kyo0221/aif_rc_teleop_ecu/production/parts_list.xlsx

Sheet: JLC実装部品
製作枚数 | 5 | ← 黄色セルを変えると数量・小計が再計算されます（Economic PCBA で実装する表面実装部品。単価・在庫はJLC API 2026-11-09取得）
No | Ref | 値 | パッケージ | LCSC番号 | メーカー型番 | 区分 | 1枚あたり数量 | 必要数 | 単価(USD) | 小計(USD) | 状態 | 備考
1 | C2,C6,C9,C10,C11,C12,C14,C20,C23 | 100nF 50V X7R ±10% | 0603 | C14663 | CC0603KRX7R9BB104 | Basic | 9 |  | 0.0060 |  | 確認済 2026-11-09 | バイパス/デカップリング JLC在庫 32,993,629（2026-11-09）
2 | C4,C5,C8,C15,C21,C24 | 1µF 50V X5R ±10% | 0603 | C15849 | CL10A105KB8NNNC | Basic | 6 |  | 0.0109 |  | 確認済 2026-11-09 | JLC在庫 12,623,126（2026-11-09）
3 | C7 | 10nF 50V X7R ±10% | 0603 | C57112 | 0603B103K500NT | Basic | 1 |  | 0.0103 |  | 確認済 2026-11-09 | JLC在庫 5,750,512（2026-11-09）
4 | C13 | 4.7µF 16V X5R ±10% | 0603 | C19666 | CL10A475KO8NNNC | Basic | 1 |  | 0.0150 |  | 確認済 2026-11-09 | C13 JLC在庫 3,723,176（2026-11-09）
5 | C16,C17 | 33pF 50V C0G ±5% | 0603 | C1663 | CL10C330JB8NNNC | Basic | 2 |  | 0.0091 |  | 確認済 2026-11-09 | Y1(CL=20pF)用。33pF直列16.5pF+浮遊容量で適合 JLC在庫 1,421,873（2026-11-09）
6 | C19,C22 | 10µF 25V X5R ±10% | 0805 | C15850 | CL21A106KAYNNNE | Basic | 2 |  | 0.0315 |  | 確認済 2026-11-09 | C19/C22 JLC在庫 8,362,759（2026-11-09）
7 | D1 | LED 黄緑 Vf2.0-2.2V 30-42mcd | 0603 | C2289 | KT-0603YG | Extended | 1 |  | 0.0106 |  | 確認済 2026-11-09 | D1=状態。色決定済み(黄緑)。暗さは実機確認 JLC在庫 36,894（2026-11-09）
8 | D2,D3,D4 | LED 赤 Vf1.8-2.4V | 0603 | C2286 | KT-0603R | Basic | 3 |  | 0.0077 |  | 確認済 2026-11-09 | D2=異常 D3=5V表示 D4=3.3V表示。色決定済み(赤)。暗さは実機確認 JLC在庫 6,497,473（2026-11-09）
9 | D5 | LED 黄 Vf2.4V 175mcd | 0603 | C2287 | KT-0603Y | Extended | 1 |  | 0.0106 |  | 確認済 2026-11-09 | D5=モード。色決定済み(黄)。暗さは実機確認 JLC在庫 86,988（2026-11-09）
10 | FB1 | 330Ω@100MHz 700mA | 0402 | C596498 | BLM15EX331SN1D | Extended | 1 |  | 0.0899 |  | 確認済 2026-11-09 | FB1 JLC在庫 36,595（2026-11-09）
11 | R1 | 120Ω ±1% | 0603 | C22787 | 0603WAF1200T5E | Basic | 1 |  | 0.0020 |  | 確認済 2026-11-09 | CAN終端 JLC在庫 2,693,768（2026-11-09）
12 | R2 | 3.3kΩ ±1% | 0603 | C22978 | 0603WAF3301T5E | Basic | 1 |  | 0.0022 |  | 確認済 2026-11-09 | 5V表示LED(D3) JLC在庫 4,761,882（2026-11-09）
13 | R3,R4,R5,R6 | 1.2kΩ ±1% | 0603 | C22765 | 0603WAF1201T5E | Basic | 4 |  | 0.0034 |  | 確認済 2026-11-09 | LED電流制限(D1,D2,D4,D5) JLC在庫 2,156,026（2026-11-09）
14 | R7 | 10kΩ ±1% | 0603 | C25804 | 0603WAF1002T5E | Basic | 1 |  | 0.0022 |  | 確認済 2026-11-09 | BOOT0プルダウン JLC在庫 46,759,857（2026-11-09）
15 | SW1 | タクトスイッチ SMD-4P 5.1×5.1 | SMD 5.1x5.1 | C318884 | TS-1187A-B-A-B | Basic | 1 |  | 0.0207 |  | 確認済 2026-11-09 | リセットSW。接点ペア要確認(要確認シート) JLC在庫 844,638（2026-11-09）
16 | U1 | STM32G474RET6 | LQFP-64 | C521608 | STM32G474RET6 | Extended | 1 |  | 13.0055 |  | 確認済 2026-11-09 | JLC在庫 153個（2026-11-09時点）。少量のため発注直前に再確認
17 | U2 | XC6206P332MR 3.3V LDO | SOT-23-3 | C5446 | XC6206P332MR-G | Basic | 1 |  | 0.1478 |  | 確認済 2026-11-09 | 入力最大6V JLC在庫 490,069（2026-11-09）
18 | U3 | CA-IS3062VW 絶縁CAN(電源内蔵) | SOIC-16W | C5338808 | CA-IS3062VW | Extended | 1 |  | 3.0163 |  | 確認済 2026-11-09 | JLC在庫 3,809個（2026-11-09時点）
19 | Y1 | 8MHz 20pF ±10ppm | 5032 2P | C115962 | X50328MSB2GI | Basic | 1 |  | 0.2461 |  | 確認済 2026-11-09 | X50328MSB2GI JLC在庫 498,737（2026-11-09）
 |  |  |  |  |  |  |  |  | 部品代合計
 |  |  |  |  |  |  |  |  | 拡張部品の品種数
 |  |  |  |  |  |  |  |  | 拡張部品手数料(目安$3/品種)

Sheet: 手はんだ部品_購入リスト
製作枚数 |  | JLCPCBの注文時にLCSCで同梱購入する想定（購入数は最小購入数を考慮。単価はJLC API 2026-11-09取得）
No | 品目 | Ref | LCSC番号 | メーカー型番 | 仕様 | 1枚あたり数量 | 必要数 | 最小購入数 | 購入数 | 単価(USD) | 小計(USD) | 購入先 | 備考
1 | 電解コンデンサ | C3 | C160200 | ERZ1HM101E12OT | 100µF 50V φ6.3×12mm P2.5 | 1 |  | 10 |  | 0.0427 |  | LCSC | 高さ12mm
2 | 基板用コネクタ XA 2P | J1 | C263753 | B02B-XASK-1(LF)(SN) | JST XA 2.5mm 2極 縦型 | 1 |  | 10 |  | 0.0717 |  | LCSC | 電源入力
3 | 基板用コネクタ XA 4P | J2 | C264994 | B04B-XASK-1(LF)(SN) | JST XA 2.5mm 4極 縦型 | 1 |  | 10 |  | 0.0864 |  | LCSC | 新規(Conn_01x04)。同名のC5306344は在庫0のためC264994を採用
4 | 基板用コネクタ XA 3P | J4 | C265055 | B03B-XASK-1(LF)(SN) | JST XA 2.5mm 3極 縦型 | 1 |  | 10 |  | 0.0833 |  | LCSC | CAN
5 | ピンヘッダ 1×40（分割用） | JP1 | C2337 | 2.54-1*40PStraight pin | 2.54mm 1列40P | 1 |  | 5 |  | 0.1615 |  | LCSC | JP1(1x2)用に2Pを切り出す（1本で20枚分）
6 | ジャンパーピン | JP1 | C2689176 | F254D-02-065-PT-B | 2.54mm ショートピン | 1 |  | 50 |  | 0.0172 |  | LCSC | 終端抵抗ON/OFF。手持ちがあれば不要
7 | ST-LINK用 1.27mm 2×7 ボックスヘッダ | J3 | C20940107 | FTSH-107-01-L-D-K | 1.27mm 2×7P THT キー付き | 1 |  | 1 |  | 3.2584 |  | LCSC | スルーホール14パッド・1.27mm 2×7をPCBで確認済。LCSC在庫301個(2026-11-09)。安価な代替: C22438122(HX PZ1.27-2x7P ZZ, 枠なし)
8 | 相手側ハウジング XA 2P | (J1ケーブル) | C157892 | XAP-02V-1 | JST XA 2極 ハウジング | 1 |  | 20 |  | 0.0334 |  | LCSC | 基板には載らない
9 | 相手側ハウジング XA 3P | (J4ケーブル) | C157891 | XAP-03V-1 | JST XA 3極 ハウジング | 1 |  | 10 |  | 0.0478 |  | LCSC | 基板には載らない
10 | 相手側ハウジング XA 4P | (J2ケーブル) | C111519 | XAP-04V-1 | JST XA 4極 ハウジング | 1 |  | 10 |  | 0.0658 |  | LCSC | 基板には載らない
11 | XA 圧着端子 | (ケーブル) | C246759 | SXA-001T-P0.6 | JST XA用 コンタクト | 9 |  | 20 |  | 0.0127 |  | LCSC | J1(2)+J2(4)+J4(3)=9極/枚。圧着工具も必要
 |  |  |  |  |  |  |  |  |  | LCSC分合計

Sheet: 要確認事項
優先度 | 内容 | 対応案
★最優先 | U1 STM32G474RET6 のJLC在庫が153個のみ（2026-11-09時点） | 数量次第で不足。発注直前に再確認し、不足ならGlobal Sourcing/他経路を検討。U3 CA-IS3062VWも在庫3,809個（Extended）
参考 | LEDの色(決定済み)・明るさ | 色決定済み: D3/D4/D2=赤(C2286)、D1=黄緑(C2289)、D5=黄(C2287)。暗さは実機確認(D1黄緑は30-42mcdと低め)。旧候補の緑C12624/C72043、黄C72038は不採用
要確認 | SW1 TS-1187A の接点ペア | 4ピンのどのペアが常時導通/押下で導通かをデータシートとフットプリントで照合
要確認 | J3 ボックスヘッダ(FTSH-107)のキー向き | 基板上の切り欠き方向とST-LINKケーブルのPin1が一致するか確認（スルーホール2×7 1.27mmは確認済）
要確認 | XAコネクタ(J1,J2,J4)のPin1/極性 | 基板シルクと配線表の対応を実物ハウジングで確認
要確認 | JLCのCPL回転・位置プレビュー | CPLはKiCad値のまま。U1,U3,U2,SW1,Y1,LEDの向きをJLC画面で確認し、必要なら回転オフセットを補正
要確認 | J3 ボックスヘッダの選定 | FTSH-107-01-L-D-K は1個$3.26（LCSC在庫301）。キー無しの安価品(C22438122)でもよいか。寸法照合が必要
推奨 | 回路図の値表記の統一（μ/u、0.1μ/100n） | BOMで同じ部品が別行に分かれるのを防ぐ
参考 | 価格 | JLC API 2026-11-09取得の1個単価。実装分はJLCがロス分も含めて購入するので実費はやや増える
