kyo0221/aif_rc_teleop_ecu/aif_rc_teleop_ecu.pdf

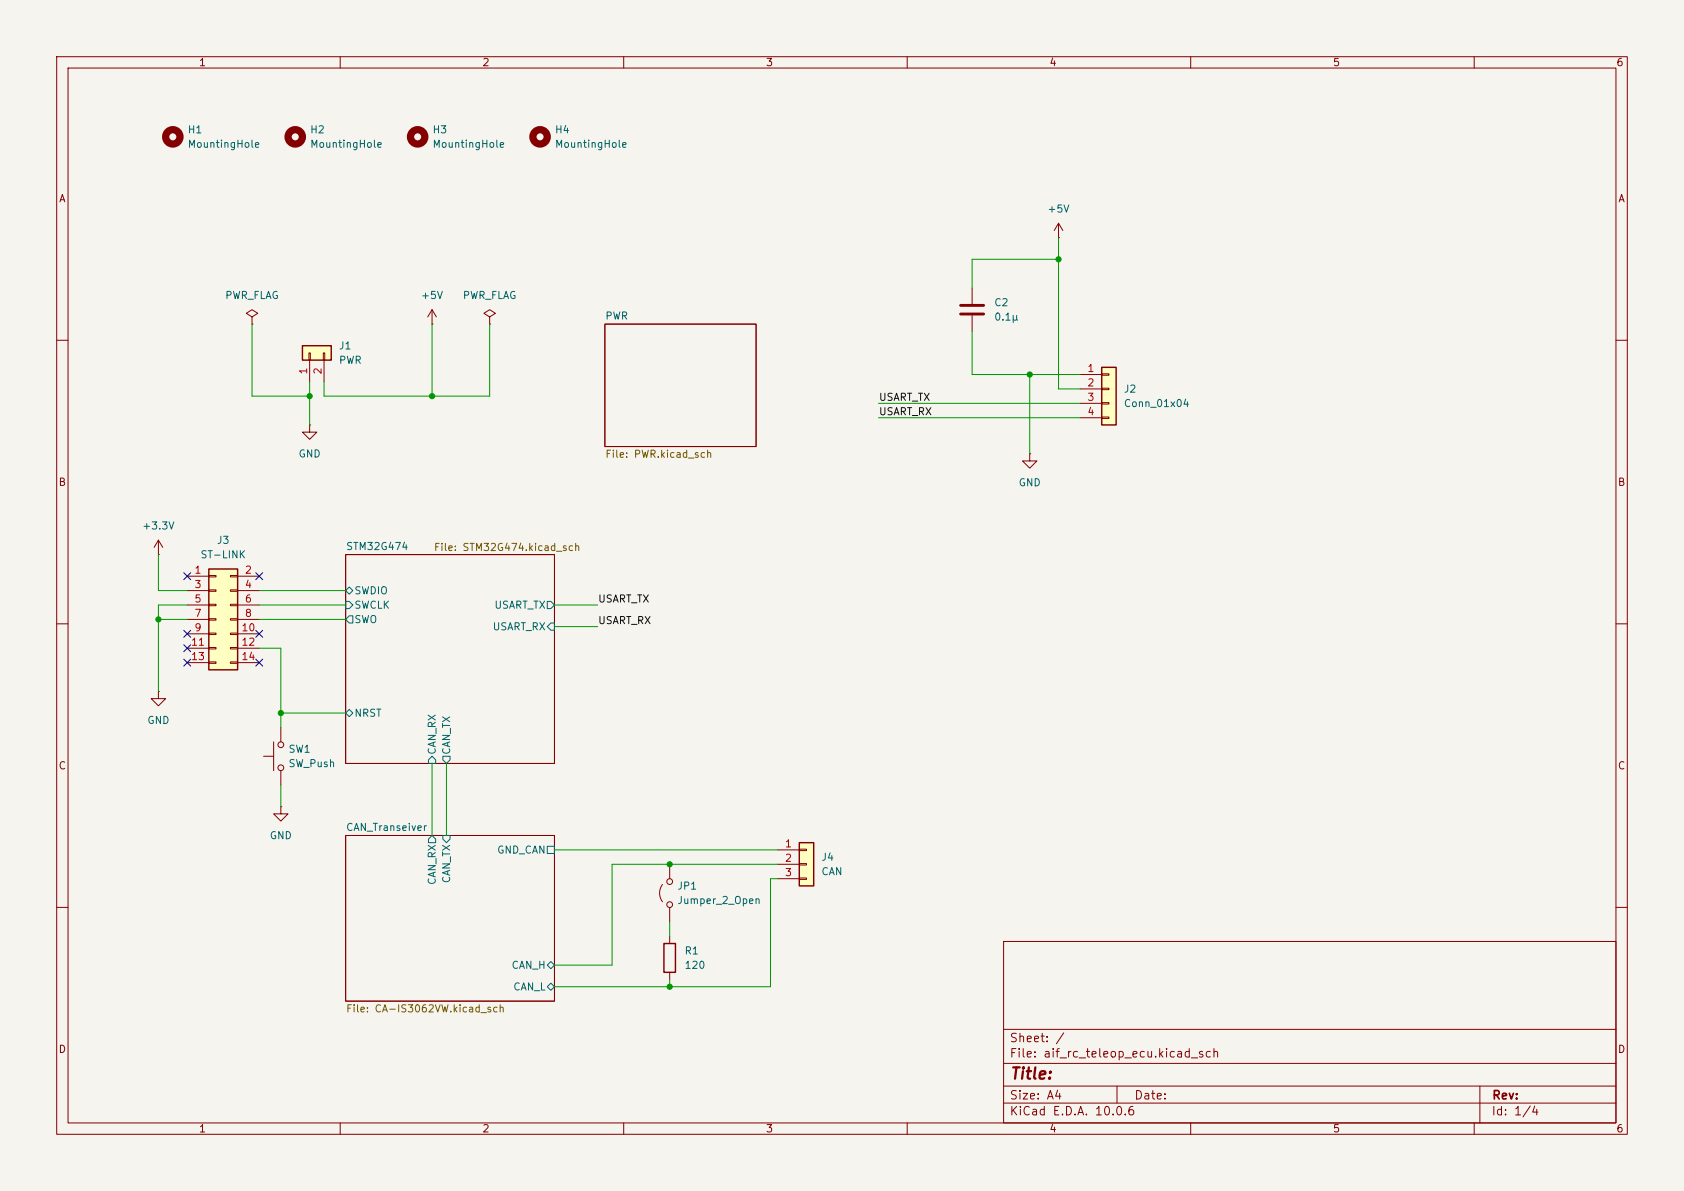
[picture p1: page 1]

Size: A4 | Rev:
KiCad E.D.A. 10.0.6 | Id: 1/4

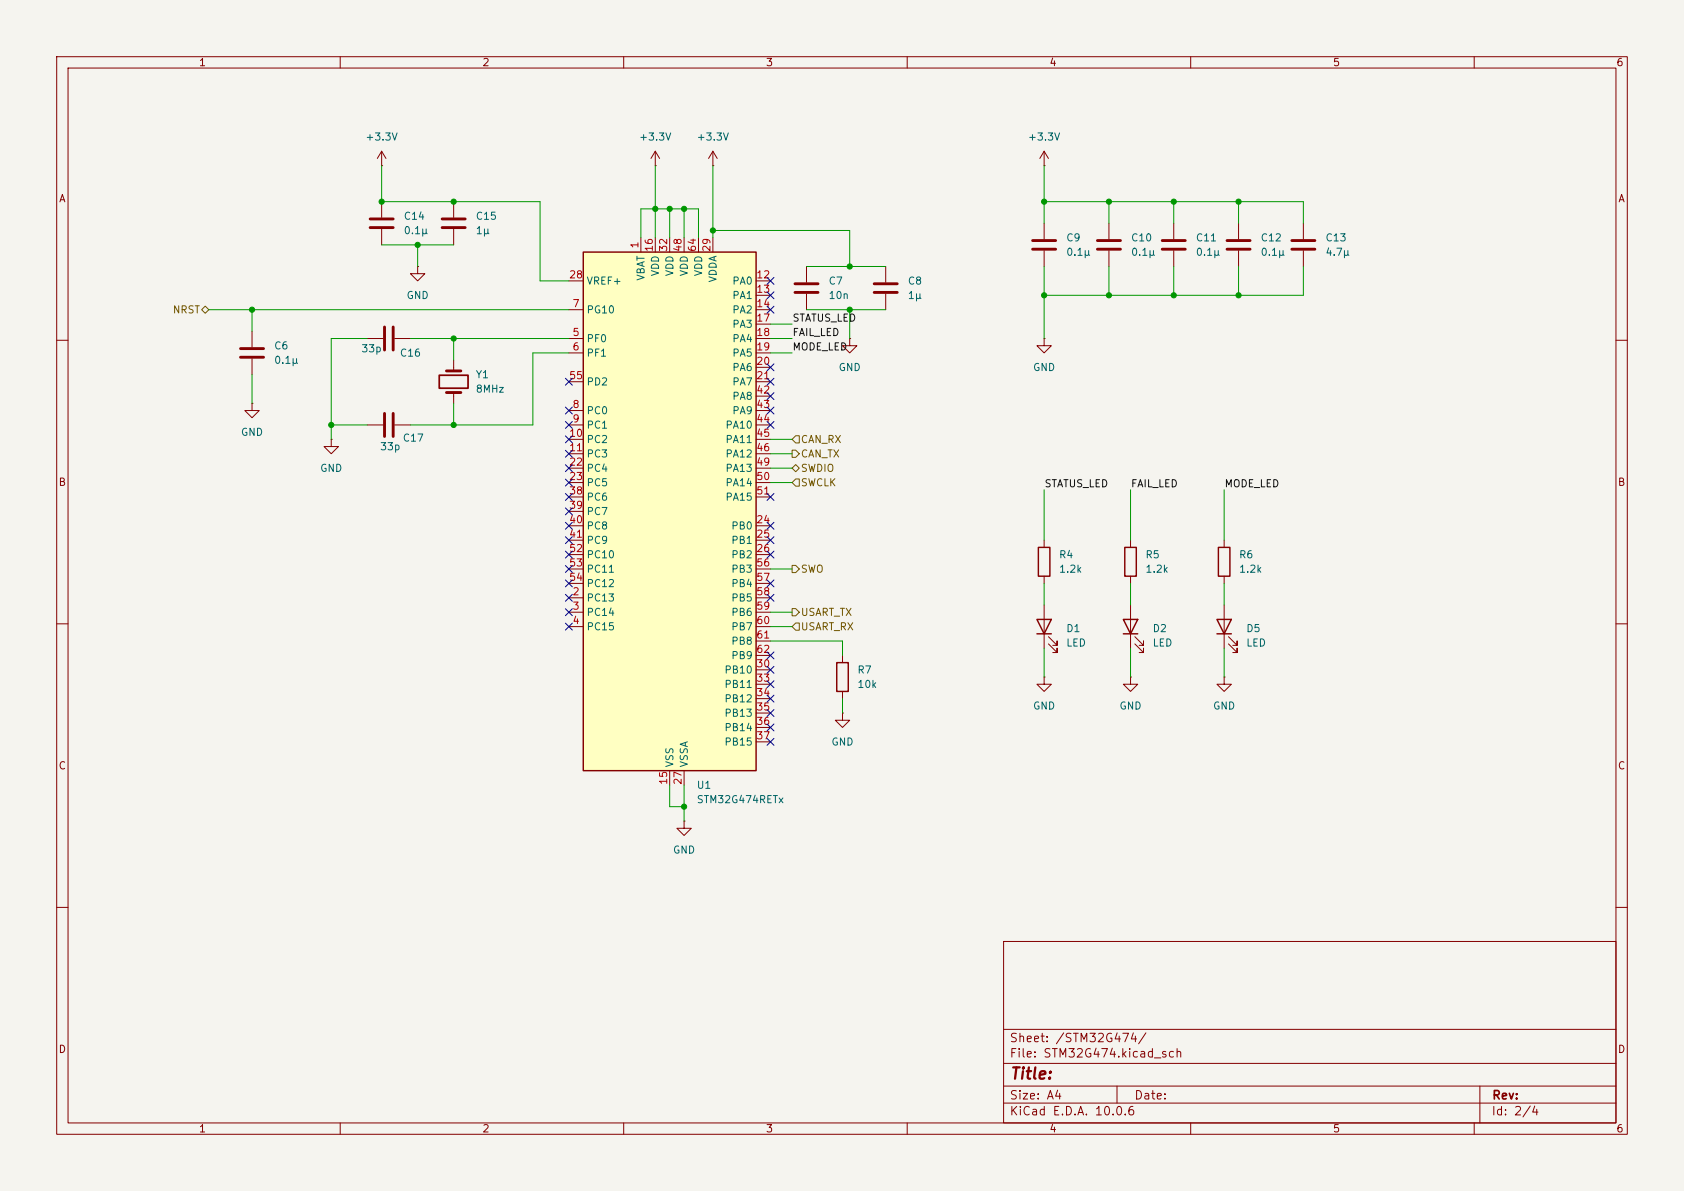
[picture p2: page 2]

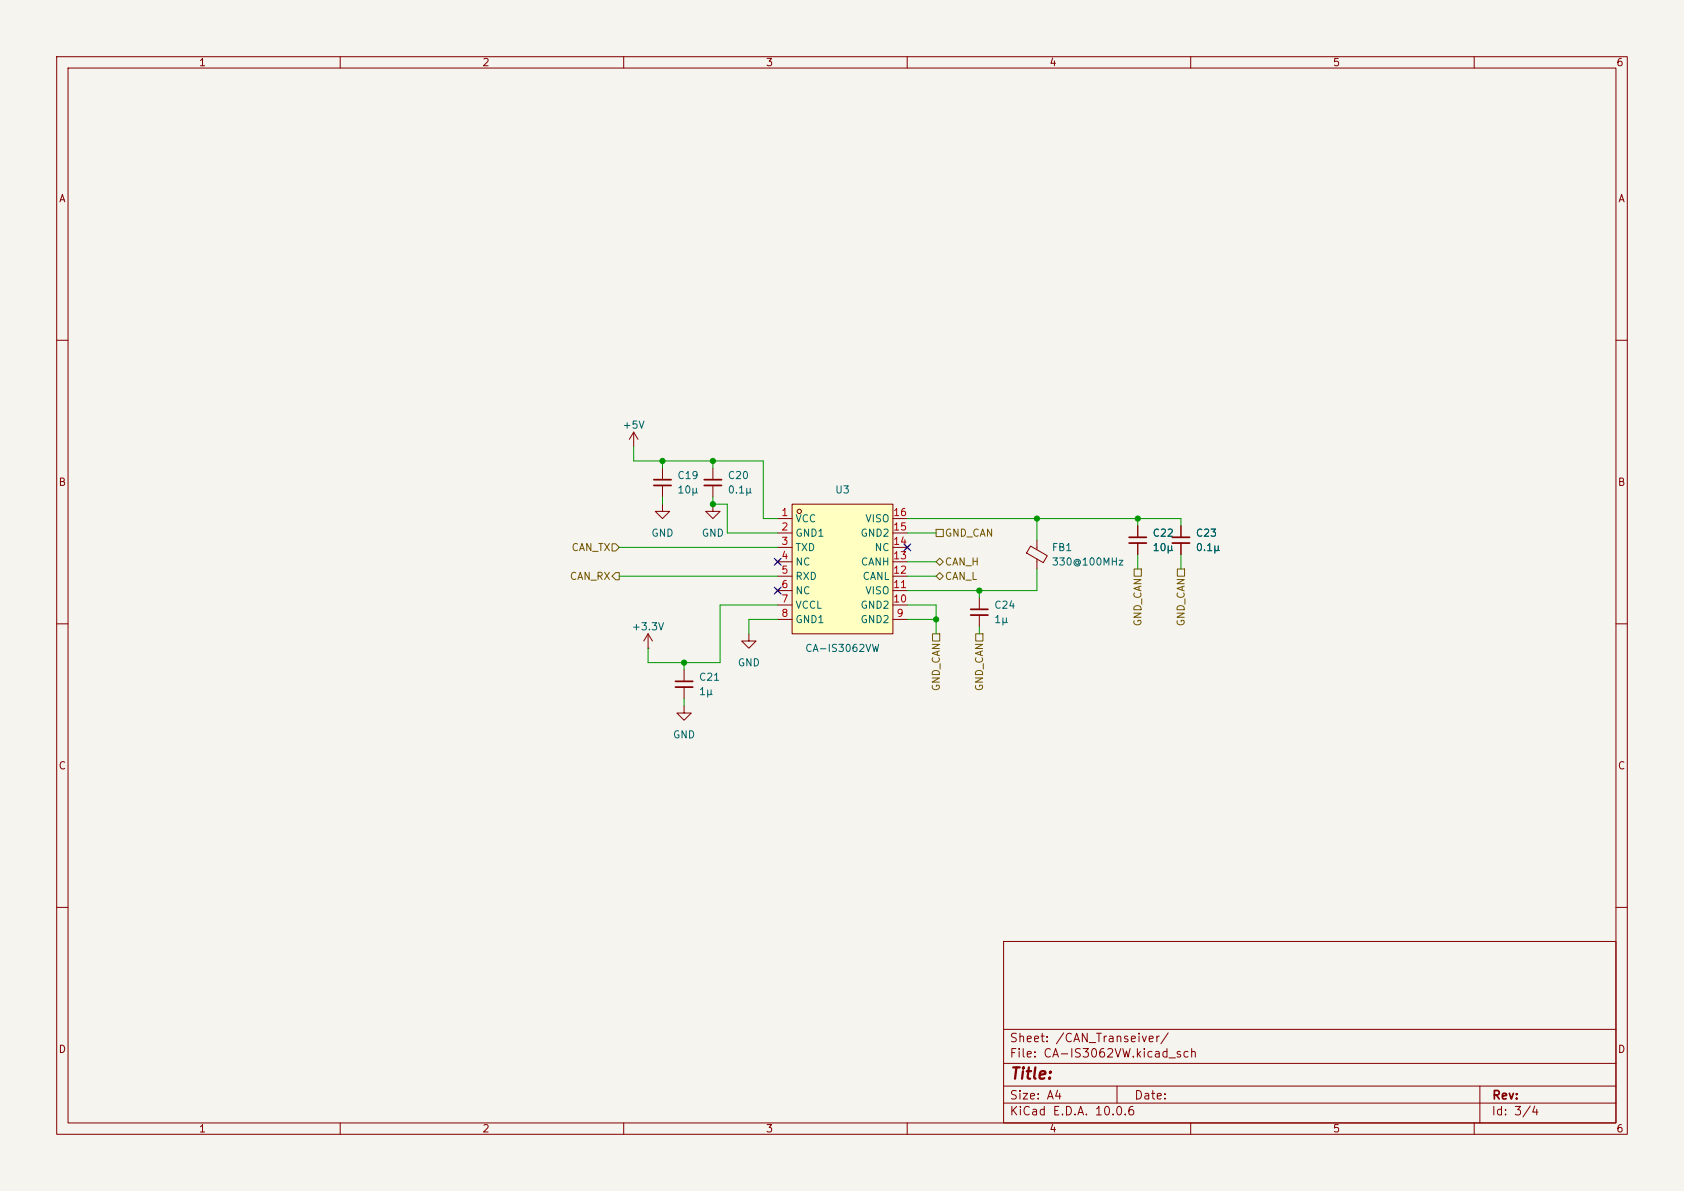
[picture p3: page 3]

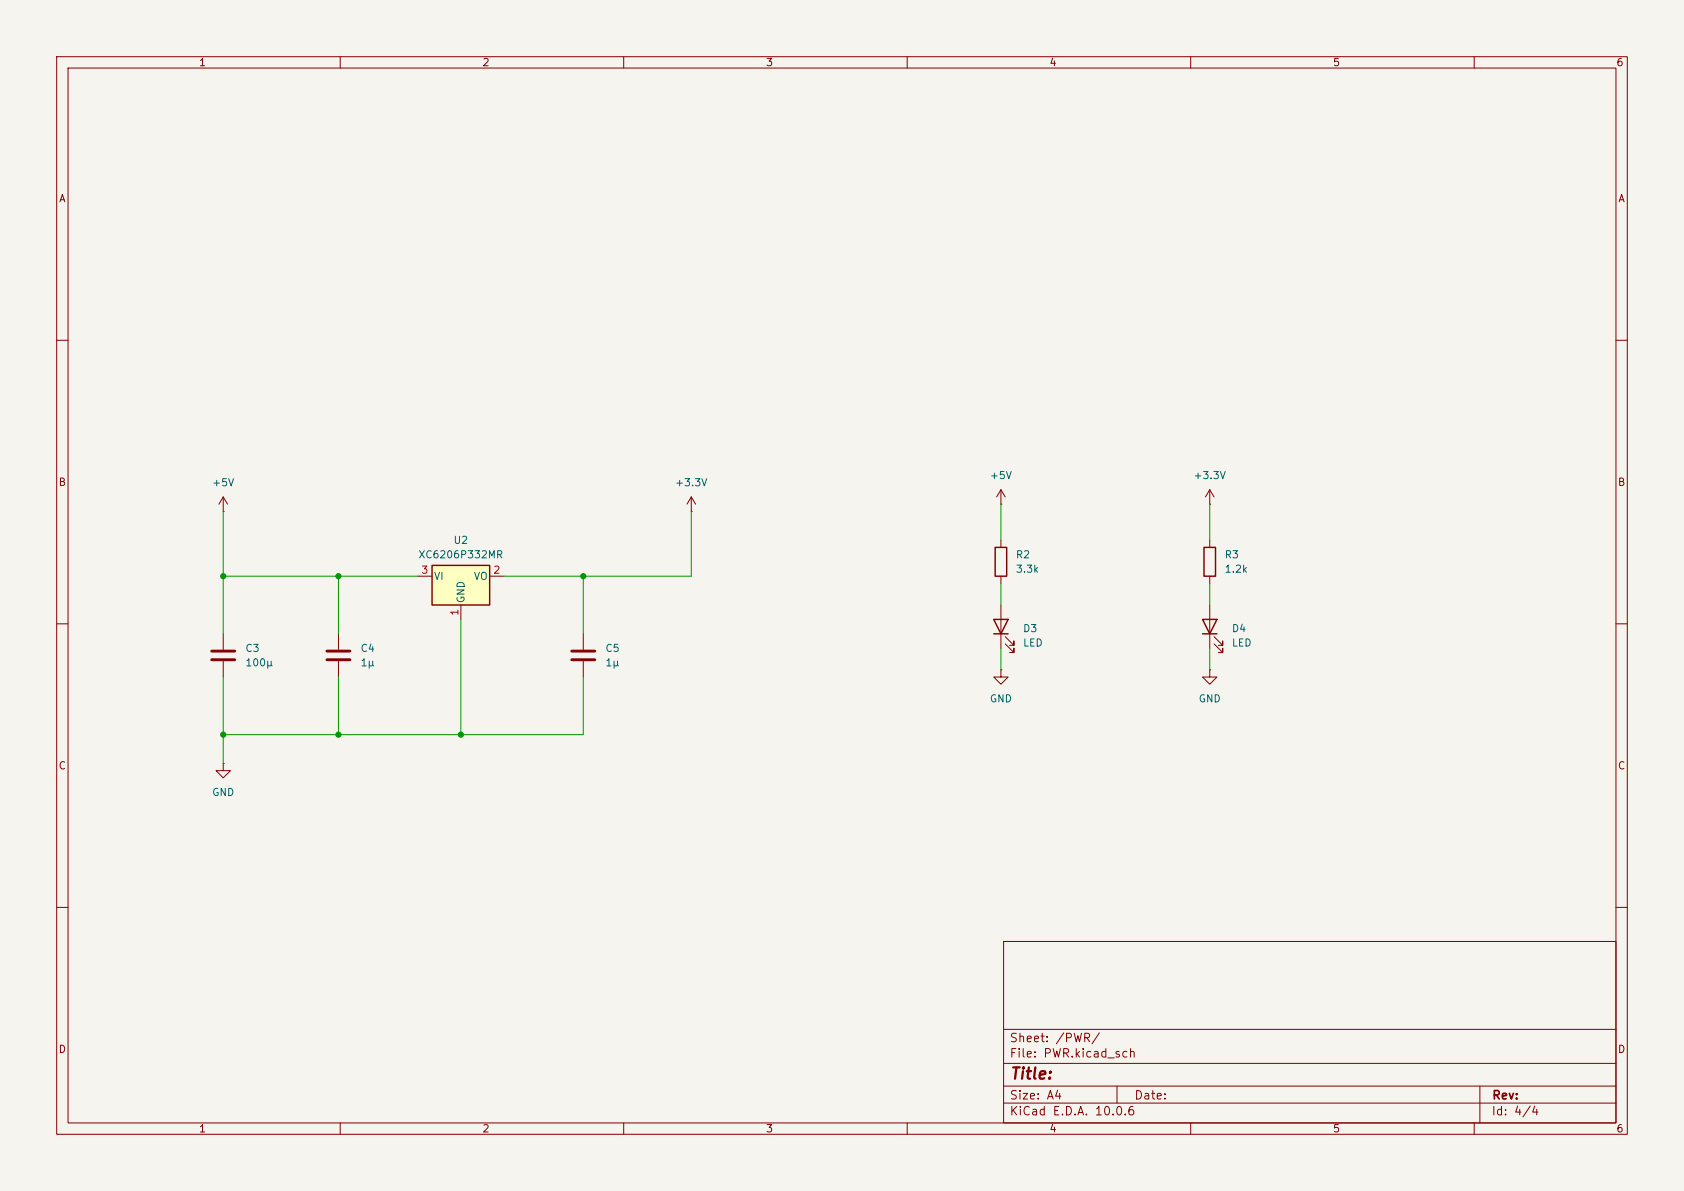
[picture p4: page 4]
