kyo0221/aif_rc_teleop_ecu/aif_rc_teleop_ecu.kicad_pcb

## KiCad design aif_rc_teleop_ecu.kicad_pcb (2026-11-10)

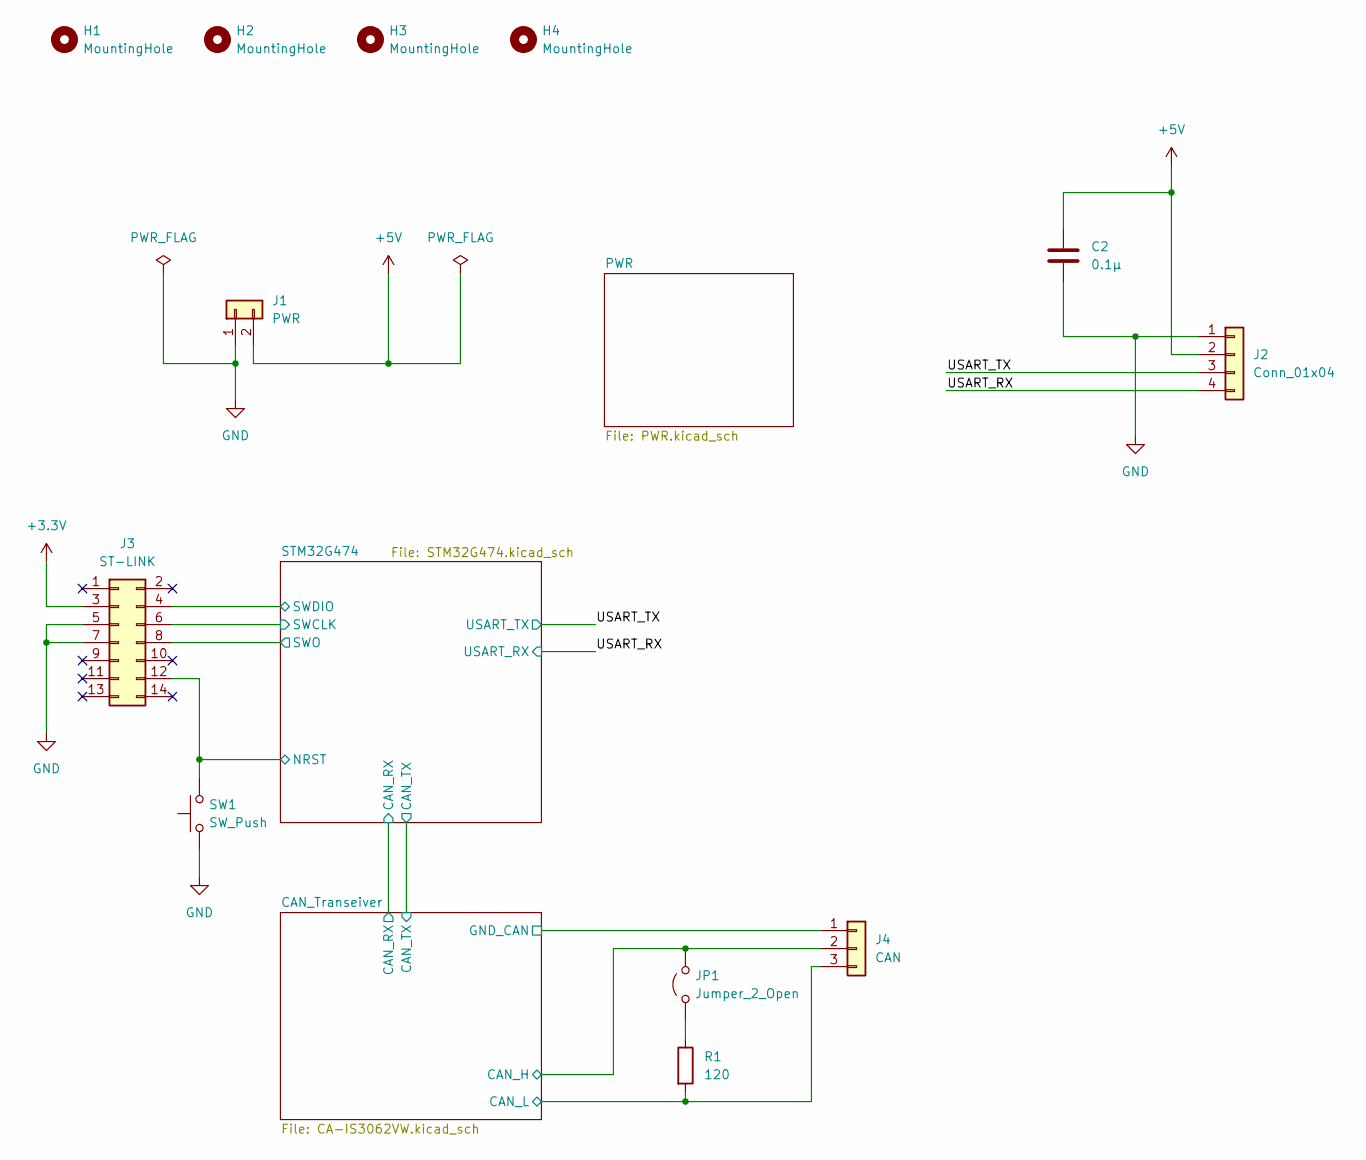
[picture p5: schematic aif_rc_teleop_ecu.kicad_sch]

Parts:
C2: 0.1μ; C_0603_1608Metric
H1, H2, H3, H4: MountingHole; MountingHole_3.2mm_M3
J1: PWR; JST_XA_B02B-XASK-1_1x02_P2.50mm_Vertical
J2: Conn_01x04; JST_XA_B04B-XASK-1_1x04_P2.50mm_Vertical
J3: ST-LINK; JTAG_BOX_CONN
J4: CAN; JST_XA_B03B-XASK-1_1x03_P2.50mm_Vertical
JP1: Jumper_2_Open; PinHeader_1x02_P2.54mm_Vertical
R1: 120; R_0603_1608Metric
SW1: SW_Push; SW_Push_1P1T_XKB_TS-1187A

Connections:
+3.3V: J3.3; also elsewhere on the board
+5V: C2.2, J1.2, J2.2; also elsewhere on the board
/CAN_Transeiver/CAN_H: J4.2, JP1.2 (B); also elsewhere on the board
/CAN_Transeiver/CAN_L: J4.3, R1.2; also elsewhere on the board
/CAN_Transeiver/GND_CAN: J4.1; also elsewhere on the board
/STM32G474/NRST: J3.12, SW1.2; also elsewhere on the board
/STM32G474/SWCLK: J3.6; also elsewhere on the board
/STM32G474/SWDIO: J3.4; also elsewhere on the board
/STM32G474/SWO: J3.8; also elsewhere on the board
/USART_RX: J2.4; also elsewhere on the board
/USART_TX: J2.3; also elsewhere on the board
GND: C2.1, J1.1, J2.1, J3.5, J3.7, SW1.1; also elsewhere on the board
unnamed: JP1.1 (A), R1.1

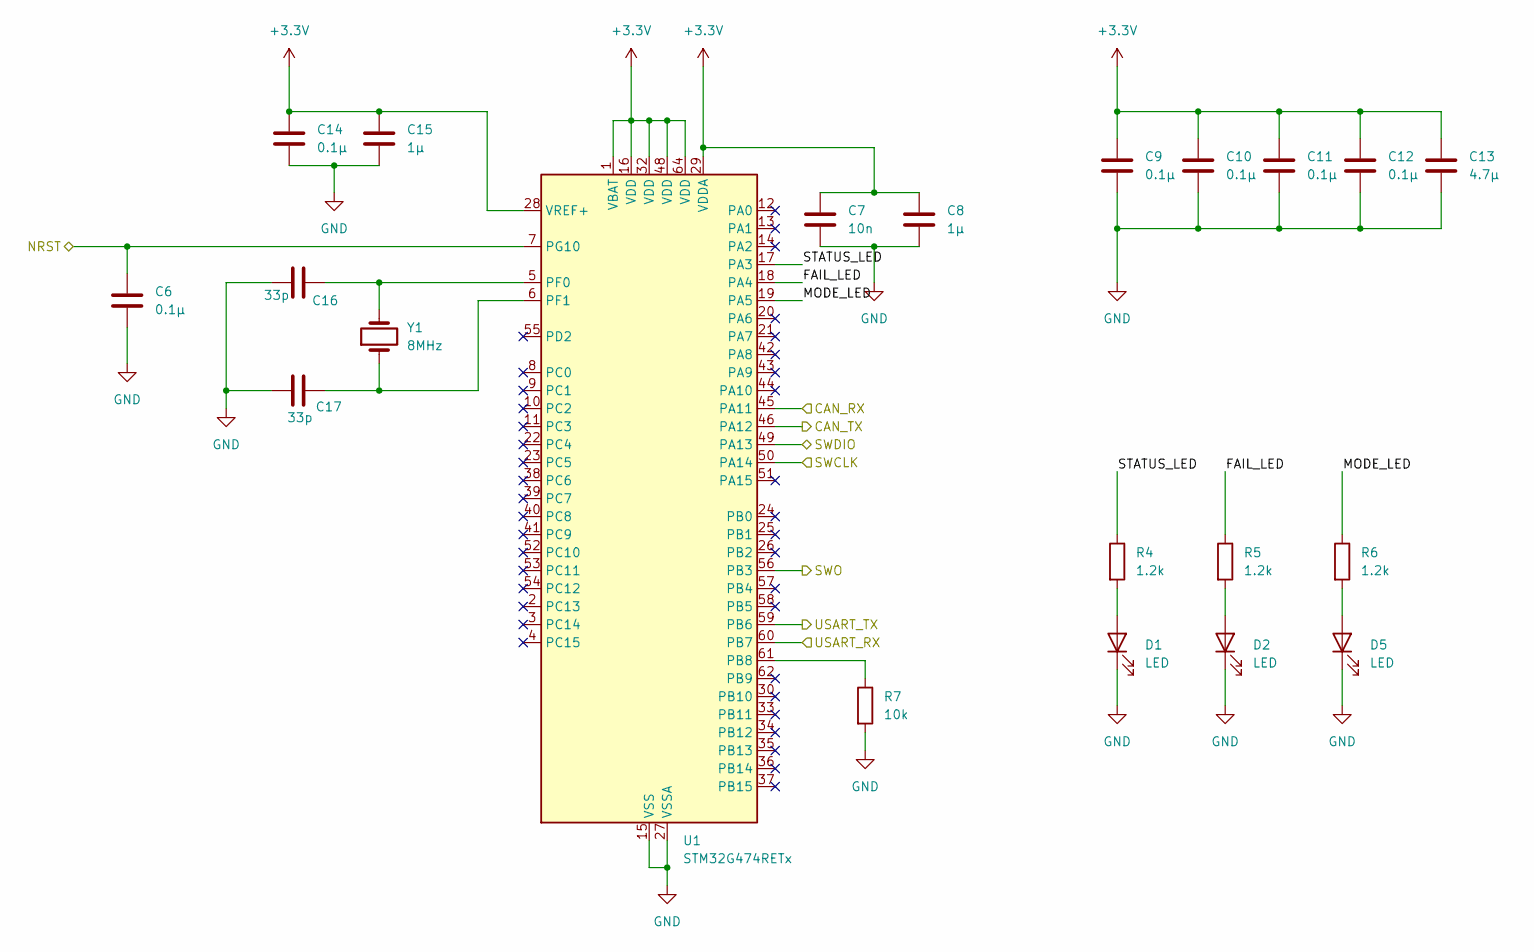
[picture p6: schematic STM32G474.kicad_sch]

Parts:
C6, C9, C10, C11, C12, C14: 0.1μ; C_0603_1608Metric
C7: 10n; C_0603_1608Metric
C8, C15: 1μ; C_0603_1608Metric
C13: 4.7μ; C_0603_1608Metric
C16, C17: 33p; C_0603_1608Metric
D1, D2, D5: LED; LED_0603_1608Metric
R4, R5, R6: 1.2k; R_0603_1608Metric
R7: 10k; R_0603_1608Metric
U1: STM32G474RETx; LQFP-64_10x10mm_P0.5mm
Y1: 8MHz; Crystal_SMD_5032-2Pin_5.0x3.2mm

Connections:
+3.3V: C7.1, C8.1, C9.1, C10.1, C11.1, C12.1, C13.1, C14.1, C15.1, U1.1 (VBAT), U1.16 (VDD), U1.28 (VREF+), U1.29 (VDDA), U1.32 (VDD), U1.48 (VDD), U1.64 (VDD); also elsewhere on the board
/CAN_Transeiver/CAN_RX: U1.45 (PA11); also elsewhere on the board
/CAN_Transeiver/CAN_TX: U1.46 (PA12); also elsewhere on the board
/STM32G474/FAIL_LED: R5.1, U1.18 (PA4)
/STM32G474/MODE_LED: R6.1, U1.19 (PA5)
/STM32G474/NRST: C6.1, U1.7 (PG10); also elsewhere on the board
/STM32G474/STATUS_LED: R4.1, U1.17 (PA3)
/STM32G474/SWCLK: U1.50 (PA14); also elsewhere on the board
/STM32G474/SWDIO: U1.49 (PA13); also elsewhere on the board
/STM32G474/SWO: U1.56 (PB3); also elsewhere on the board
/USART_RX: U1.60 (PB7); also elsewhere on the board
/USART_TX: U1.59 (PB6); also elsewhere on the board
GND: C6.2, C7.2, C8.2, C9.2, C10.2, C11.2, C12.2, C13.2, C14.2, C15.2, C16.1, C17.1, D1.1 (K), D2.1 (K), D5.1 (K), R7.2, U1.15 (VSS), U1.27 (VSSA), U1.31 (VSS), U1.47 (VSS), U1.63 (VSS); also elsewhere on the board
unnamed: D1.2 (A), R4.2
unnamed: D2.2 (A), R5.2
unnamed: D5.2 (A), R6.2
unnamed: R7.1, U1.61 (PB8)
unnamed: C16.2, U1.5 (PF0), Y1.2
unnamed: C17.2, U1.6 (PF1), Y1.1

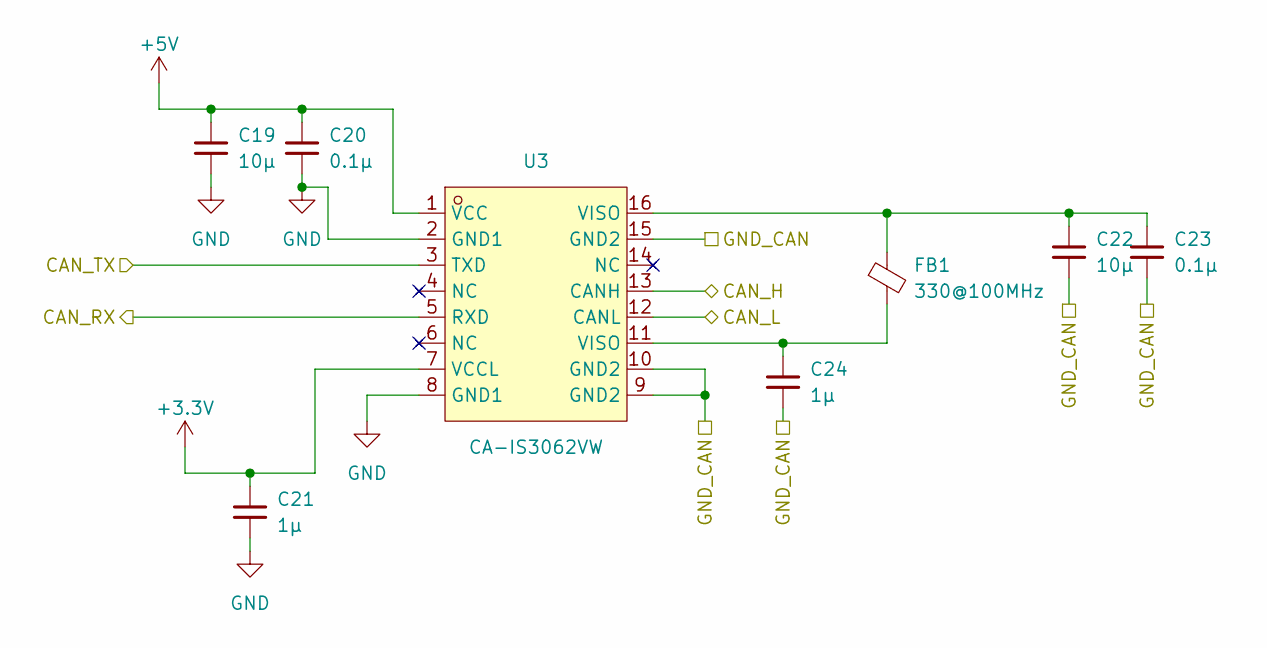
[picture p7: schematic CA-IS3062VW.kicad_sch]

Parts:
C19, C22: 10μ; C_0805_2012Metric; LCSC C15850
C20, C23: 0.1μ; C_0603_1608Metric; LCSC C14663
C21, C24: 1μ; C_0603_1608Metric; LCSC C15849
FB1: 330@100MHz; L_0402_1005Metric; MPN BLM15EX331SN1D; LCSC C596498
U3: CA-IS3062VW; SOIC-16W_7.5x10.3mm_P1.27mm; MPN CA-IS3062VW; LCSC C5338808

Connections:
+3.3V: C21.1, U3.7 (VCCL); also elsewhere on the board
+5V: C19.1, C20.1, U3.1 (VCC); also elsewhere on the board
/CAN_Transeiver/CAN_H: U3.13 (CANH); also elsewhere on the board
/CAN_Transeiver/CAN_L: U3.12 (CANL); also elsewhere on the board
/CAN_Transeiver/CAN_RX: U3.5 (RXD); also elsewhere on the board
/CAN_Transeiver/CAN_TX: U3.3 (TXD); also elsewhere on the board
/CAN_Transeiver/GND_CAN: C22.2, C23.2, C24.2, U3.9 (GND2), U3.10 (GND2), U3.15 (GND2); also elsewhere on the board
GND: C19.2, C20.2, C21.2, U3.2 (GND1), U3.8 (GND1); also elsewhere on the board
unnamed: C22.1, C23.1, FB1.1, U3.16 (VISO)
unnamed: C24.1, FB1.2, U3.11 (VISO)

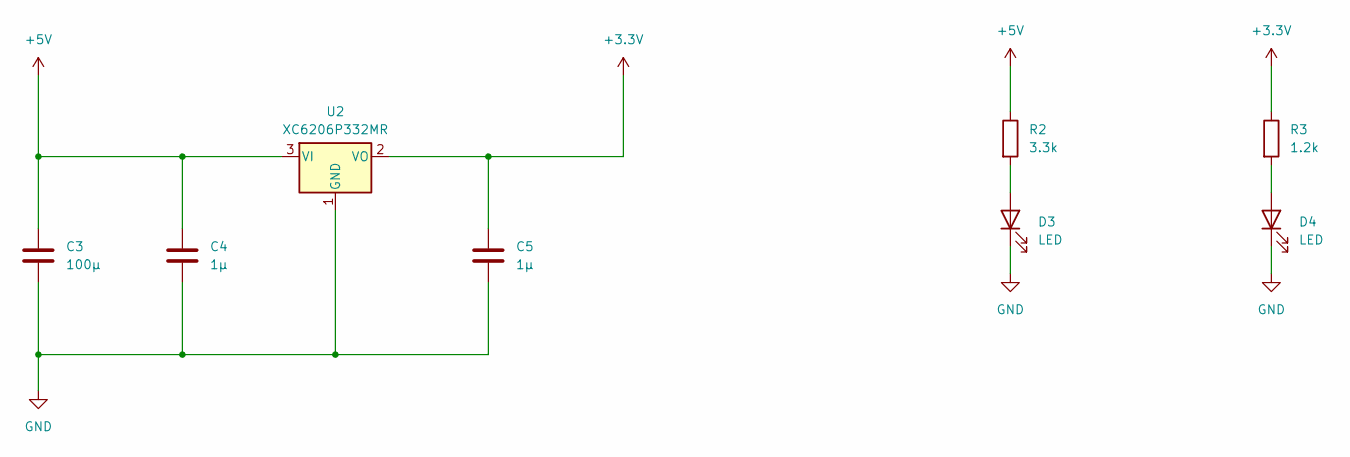
[picture p8: schematic PWR.kicad_sch]

Parts:
C3: 100μ; CP_Radial_D6.3mm_P2.50mm
C4, C5: 1μ; C_0603_1608Metric
D3, D4: LED; LED_0603_1608Metric
R2: 3.3k; R_0603_1608Metric
R3: 1.2k; R_0603_1608Metric
U2: XC6206P332MR; SOT-23-3

Connections:
+3.3V: C5.1, R3.1, U2.2 (VO); also elsewhere on the board
+5V: C3.1, C4.1, R2.1, U2.3 (VI); also elsewhere on the board
GND: C3.2, C4.2, C5.2, D3.1 (K), D4.1 (K), U2.1 (GND); also elsewhere on the board
unnamed: D3.2 (A), R2.2
unnamed: D4.2 (A), R3.2

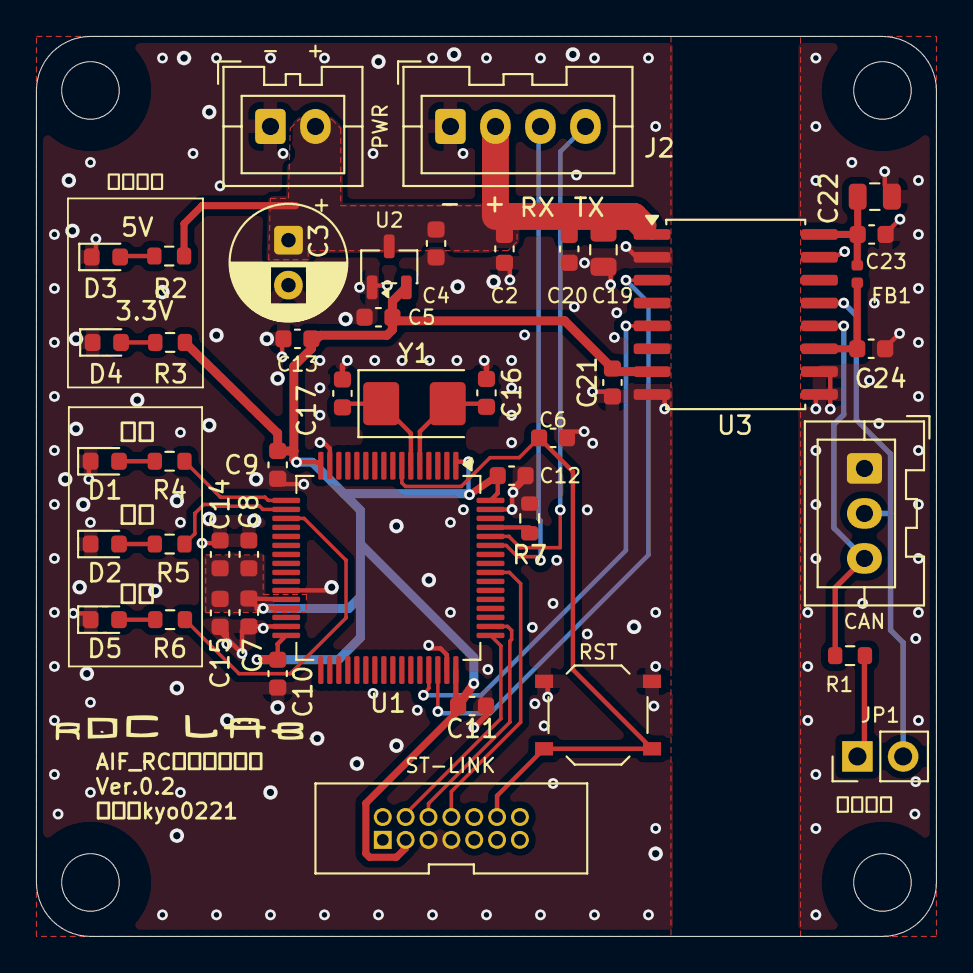
[picture p9: board aif_rc_teleop_ecu.kicad_pcb from above]

Board: 2 copper layers, 50.0 x 50.0 mm, 49 parts (0 on the bottom side), 28 nets.
