kyo0221/aif_rc_teleop_ecu/(commit log)

2026-09-28 init commit
    [aif_rc_teleop_ecu.kicad_pcb, aif_rc_teleop_ecu.kicad_sch]
2026-09-29 wip: 回路図作成作業中
    [aif_rc_teleop_ecu.kicad_sch]
2026-09-29 wip: 作業中
    [STM32G474.kicad_sch, aif_rc_teleop_ecu.kicad_sch]
2026-09-30 feat: 回路図一旦完成
    [PWR.kicad_sch, STM32G474.kicad_sch, aif_rc_teleop_ecu.kicad_sch]
2026-09-30 wip: pcb作業中
    [aif_rc_teleop_ecu.kicad_pcb, aif_rc_teleop_ecu.kicad_sch]
2026-10-02 fix: バグ修正
    [CA-IS3062VW.kicad_sch, ISOW1044.kicad_sch, aif_rc_teleop_ecu.kicad_pcb, aif_rc_teleop_ecu.kicad_sch, parts_list.xlsx]
2026-10-05 feat: 回路図pdf追加
    [CA-IS3062VW.kicad_sch, aif_rc_teleop_ecu.kicad_pcb, aif_rc_teleop_ecu.kicad_sch]
2026-10-09 feat: 水晶振動子追加とer6ピンをxaコネクタに変更
    [STM32G474.kicad_sch, aif_rc_teleop_ecu.kicad_pcb]
2026-10-10 feat: pcb再設計
    [CA-IS3062VW.kicad_sch, PWR.kicad_sch, STM32G474.kicad_sch, aif_rc_teleop_ecu.kicad_pcb, aif_rc_teleop_ecu.kicad_sch]
2026-10-10 feat: 回路図更新
2026-10-11 fix: 隠れているシルク印字を修正
2026-10-25 fix: 添削内容を踏まえて修正
2026-11-09 fix: 部品実装・LED修正
2026-11-10 fix: 微修正
2026-11-10 feat: 発注用zip
2026-11-11 fix: 向き修正
